GameZebra/BalanceMaster/README.md

# BalanceMaster
A two-wheeled robot that has to balance itself upright

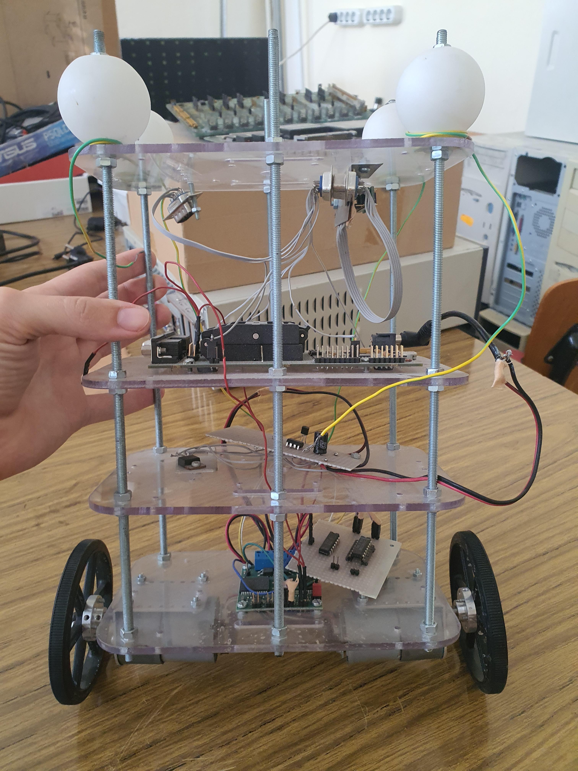
[picture p1: media/robot_upright.jpeg]
Picture of the robot


The board has a polou dual motor driver qik_2s12v10
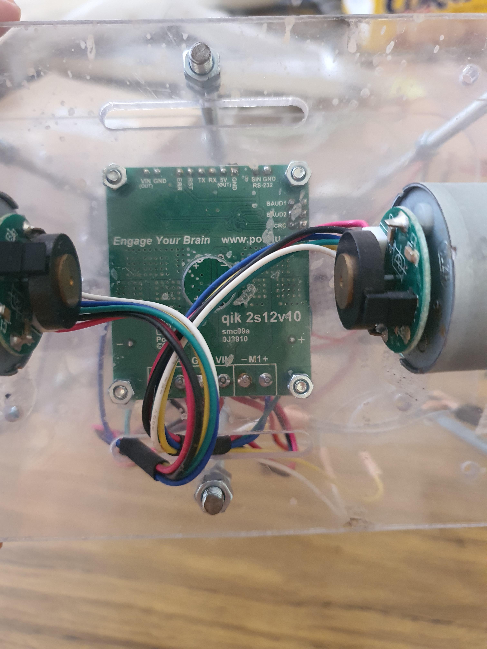
[picture p2: media/motor_driver.jpeg]
Picture of the driver
 

and ADXRS623 gyroscope
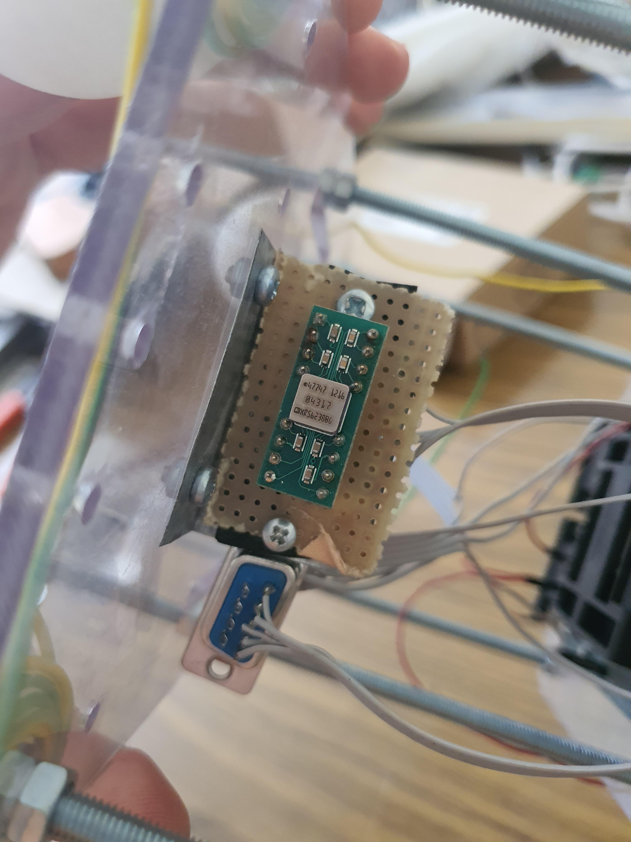
[picture p3: media/gyroscope.jpeg]
