GameZebra/BalanceMaster/docs/log.md

## 📅 May 11, 2025
- 🔍 Research on documentation strategies
- :page_facing_up: log file created
- :page_facing_up: cheetsheet

## 📅 May 12, 2025
- 🔧 Soldered BMS and balancing wires to the battery pack
- 🔧 tested battery capacity (they cant reach 4.20, max 4.15)
- 🎨 made 3d model bracket for the power button

## 📅 May 13, 2025
- 📦 printed the power button bracket
- 🔧 Soldered and fitted the button on the robot
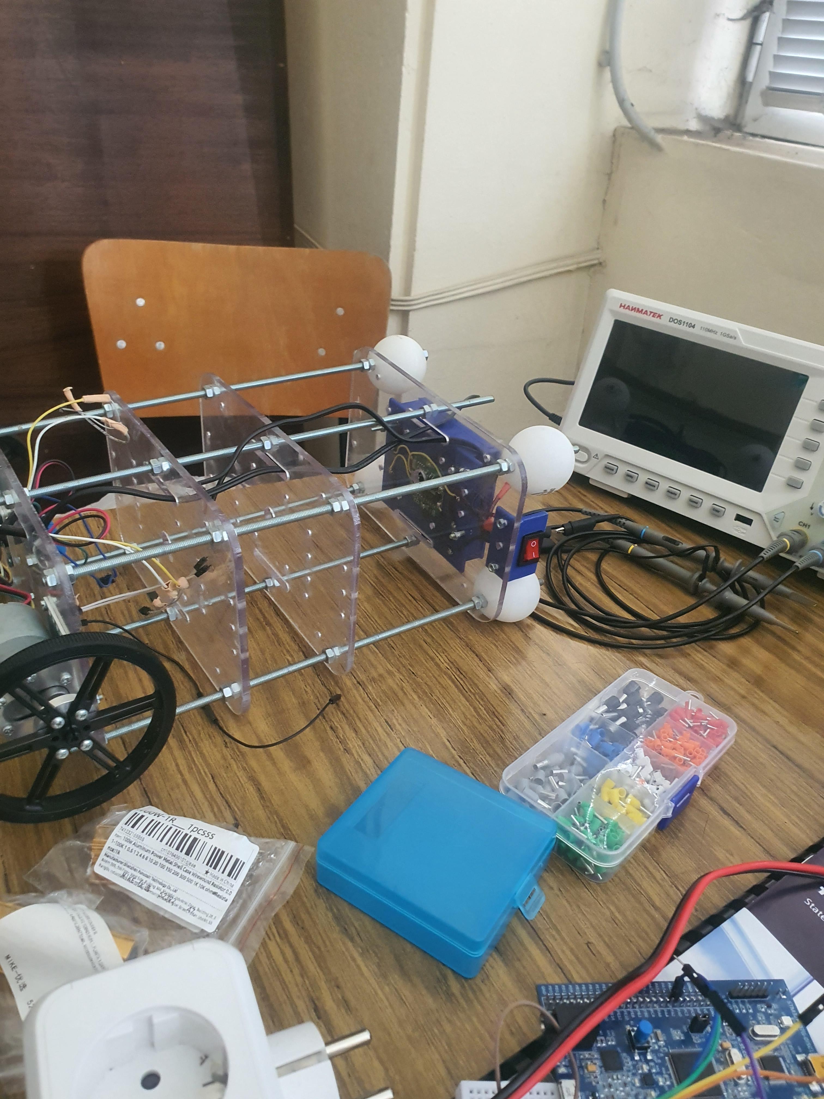
[picture p4: media/fitted_battery_pack_and_power_button.jpeg]
robot fitted with battery pack and power button
  
- 🔧 Made a power rail with buck convertors to stabilize the power
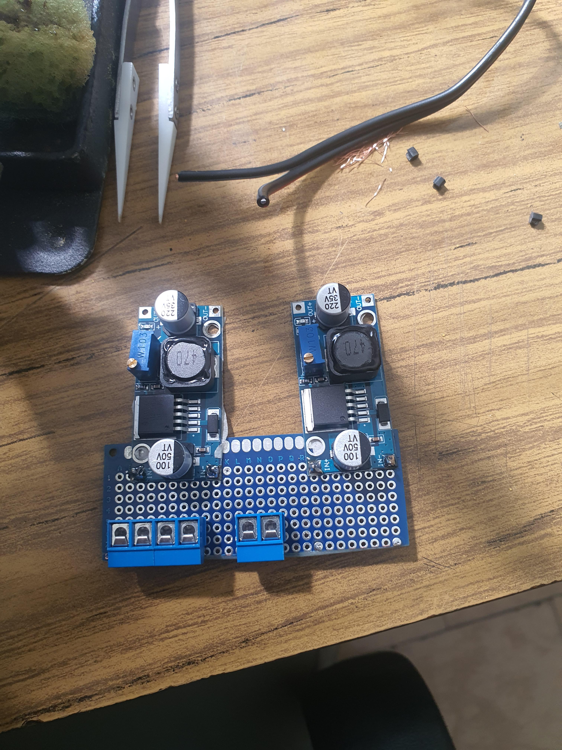
[picture p5: media/power_rail.jpeg]
power rail the upper side of the power rail
  

## 📅 May 14, 2025
- :page_facing_up: fixed prior log data
- 🔍 retested gyro
- 🔧 created gyro board and fited it to the robot
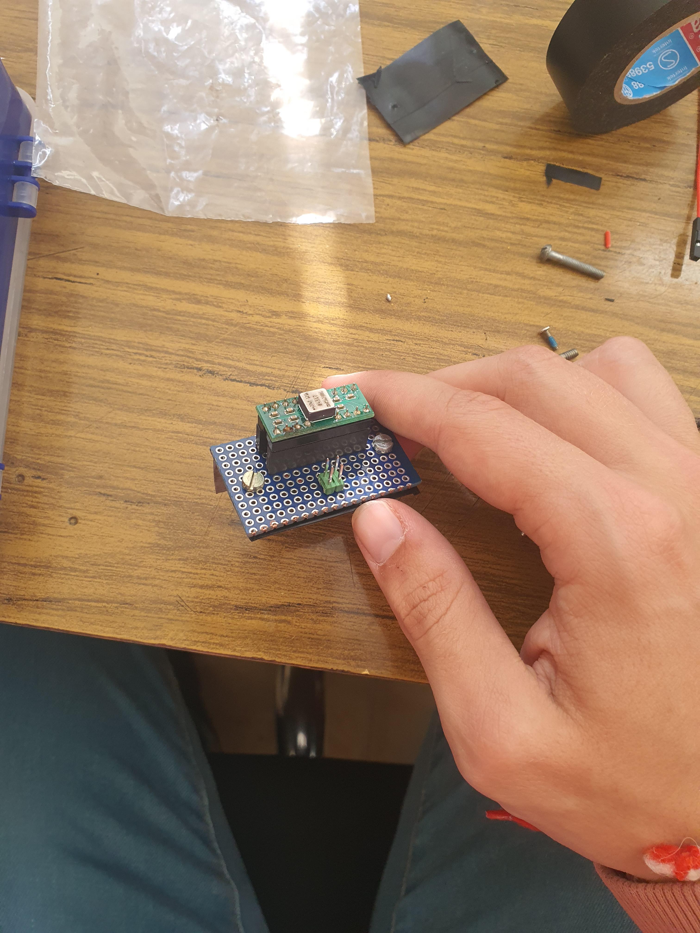
[picture p6: media/gyroscope_board.jpeg]
gyroscope board
 
- :page_facing_up: to the user data file created on the tablet

## 📅 May 15, 2025
- :page_facing_up: created pinout for the project + future improvements
- 🔍 retested gyro on 3V (because the stm32f407 board can read with the ADC up to 3V)
- 🔧 fixed the gyro board to output 3V
- 🔧 created MCU board and fited it to the robot
    - used multitool for the first time
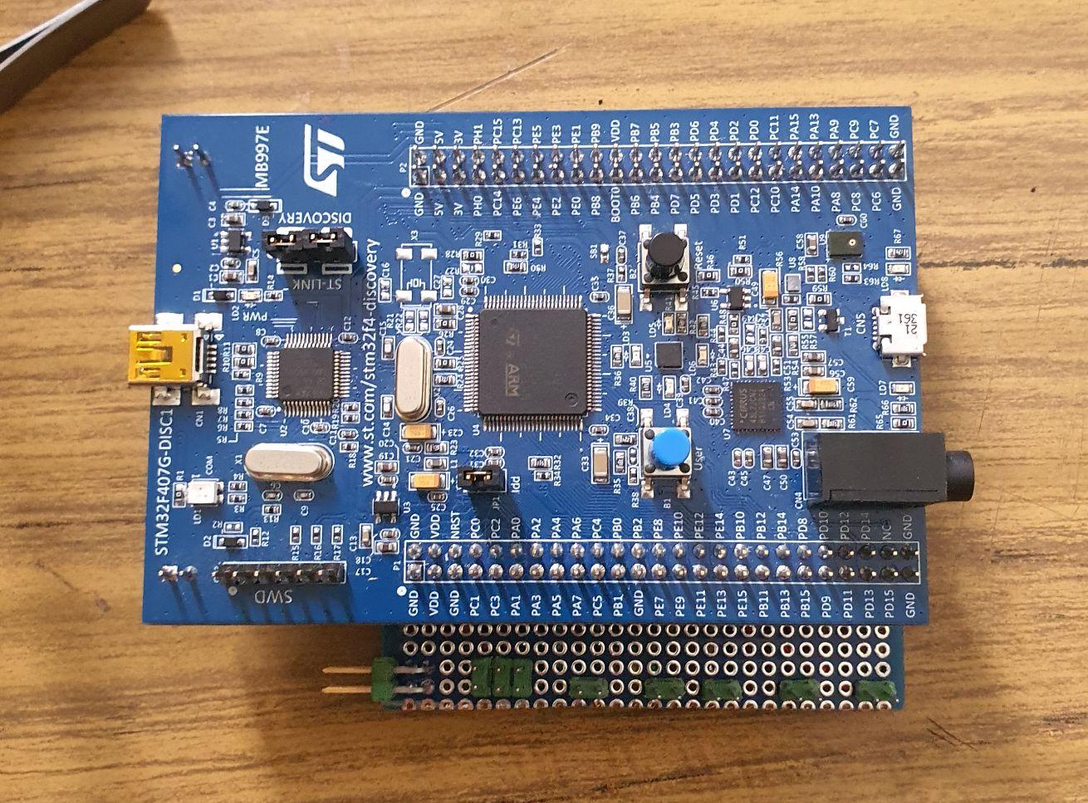
[picture p7: media/MCU_board.jpeg]
MCU board
 
- :page_facing_up: created doc file for the board shield on the tablet
- 🤖 robot hardware done
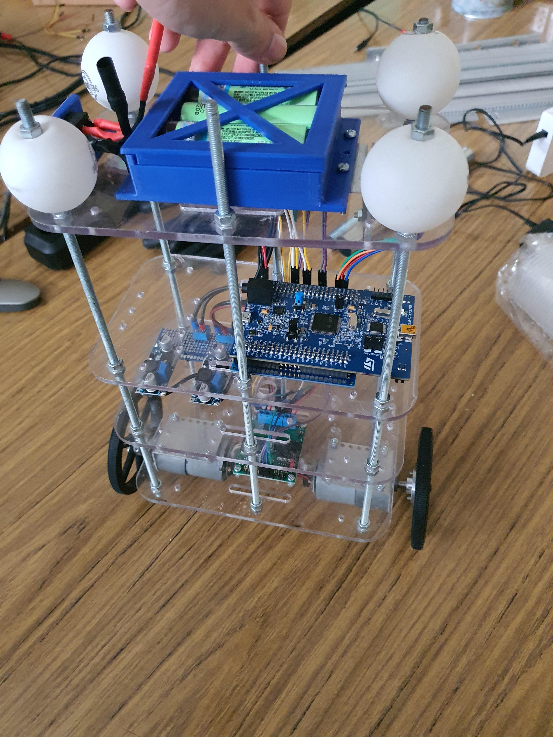
[picture p8: media/robot_upgrade_done.jpeg]
robot upgrade done
 

## 📅 May 20, 2025
- 💻 fixed the Franken bot file, now:
    - reads the gyroscope
    - reads the accelerometer
    - controls the motors
- 💻 added PID algorythim
- 🤖 baddly configured PID, but the robot is trying to stabilize itself

## 📅 May 22, 2025
- 💻 spend a lot of time trying different PID values - didn't work well
    - the robot is trying to stabilize itself, it's much better than the first iteration, 
    BUT it still can't stabilize the robot, nor to compensate for a high diviation from 
    the stable position
    - when the Kd is high the robot seems closer to stabilizeing itself, BUT it's a lot jurkey
    and this heats the motors and the buck converter that stabilizes the volteg for the motor driver
    (to the point taht the buck converter shuts off). Probbably the frequent change in direction 
    requieres high amount of current without almost any meaningfull result
    - tried using a deadzone around the work point, but this worked badly for the responsiveness
    and worked good for the overheating of the motors 
- :page_facing_up: i used already derived differential equations for the mechanics of an inverted pengulum
and derived a State space model from them (by hand)
- 🧠 I am thinking that a much hidher Kd will be required but this makes the motors to overheat
and that's far from ideal. Probbably i should try:
    - filtration of the accelerometer signal 
    - use the gyro - even thou it's signal is far from ideal (correct) it may suffer less from the noise
    generated from the motors (whem jurking around the stable position)
- :page_facing_up: TODO try:
    - high Kd component and larger deadzone
        - i want to get the robot atleast to ascilate around the work point
    - filtration of the signal
    - measure the parameters of the robot and try to create a model in matlab
    - tune a PID in matlab and try it on the robot to see if the model created has anything in common with the actual robot

## 📅 May 23, 2025
- 💻 impemented moving average
    - there is improvement but even thou somethimes there are spikes and, i'm thinkig 
    - I may try adding the average value as current value, this way I'll have even better filtration
- :page_facing_up: I still had large spikes in the Kd component
- 🔍 found a YouTube channel that has decent math and controll videos
    - watched the tutorials for Complex Analisis
- 🔍 found a MatLab example of an inverted pengulum controll which i can try
- 💻 tryed swapping the accelerometer with the gyro
    - didn't go well, i activated a timer to periodically return the gyro in the "correct" angle valye, but how do i know it is "correct"?
    it behaved as a gyro with wrong zero and then when it synced - just jumped on the side, and this was happening every second 
    - if i want to use the gyro I must prepare the data better first
- 🧠 I am thinking that:
    - apart from the filtration i may need to secure better the controller to the body of the robot
    because this way I'm amplifying the vibrations  
    - I may also look at the filtrations that we used in the labs for System Identification
- 🧠 How to implement sequential control? 
    - upright stabilization is acheived by following the zero degrees angle
    - and to acheive movement i can dynamicaly change the target angle so that the car moves linearly in space

## 📅 May 27, 2025
- 🔧 fixed the controler ant the accelerometer to the body of the robot better to limit the vibrations
    - and it is working verry well
- 💻 impemented moving average filtration
    - A great stupidity actually, I'had suspicions about that but
    - this way the angle tends to zero, and is not usefull at all
- 🔍 maged to connect the osciloscope with the PC (it needs it's USB cable to work properly)
- 🔍 The command "Get Motor M0/M1 Speed" returns the speed the driver is trying to speed the motors to - So it's not practical for checking 
if the motrs are not moveing
- 🔍 The command "Get Motor M0/M1 Current" returns average motor current for the past 5ms (+/-20%)
- 🔧 I measured the current throught the motors and the driver in different working conditions (including work mode)
    - TODO: analize the results why does the controller shuts down?
- 💻 improved the encoders demo code:
    - works with both encoders on the propper channels 
    - calculates the wheels actual speed

## 📅 May 28, 2025
- 💻 added code for the second encoders
    - it's interesting how when the encoder variable overflows, the speed variable overflows as well and i don't have massive speed reading
    - min speed added
- 💻 implemented brake before reversing
    - almost workiing

## 📅 May 29, 2025
- 💻 implemented brake before reversing
    - fixed the brake before reversing now stops whell
- 🧠 fix the zero position with bias for the angle
    - implementation (configuration required)

## 📅 May 30, 2025
- 💻 fix the zero position with bias for the angle
    - implementation (configuration required)
- 💥 managed to fry the buck converter that was supplying energy to the motor driver
- 🔧 measured the weight of the robot (to use in matematical model)

## 📅 June 02, 2025
- 🔍 Watched state space tutorials 
- 🔧 got new Buck converter (the same as the last one)

## 📅 June 03, 2025
- 🔍 played with the examples from the tutorials
- 💻 tried to implement angle correction on startup
    - i oscilate it by hand and it finds where the delta is smallest
     unfortunately (i suppose due to the noise of the accelerometer) this way the resulted setpoint is far from the actual zero
- 💻 changed the Kd to be basesd on the previous angle and not on the error to presumably limit the efect on the error based on the adaptive function that changes the angle
- 💻 remove the Ki because of double integration!!!
- 🔍 watched more from the control bootcamp
- 🧠 I talked with my mentor and it is highly advisable to have recordings of the performance of the robot in different strategies
    - with or without Ki
    - for this i have TODO a matlab file that can record the internal states of my robot

## 📅 June 04, 2025
- 🔍 watched more from the control bootcamp
- 💻 created a function that prints the important data to the PC via UART
    - the problem is that when i try to print everything the controll is visibly slower
    - Probbably i will have to use DMA for this
    - or just up the clock speed of the MCU because right now it is at 8 MHz
- 🔍 an interesting fact is the data types with wich the data from the experiment .txt .dat .bin
    - to save the data in .txt will require to convert the data to string first which is impractical for real time aplications
    - so i'll save the data as .bin and convert it in matlab later
    - .dat is some form of hybrid between the two where the data can be different file formats
- 💻 definately the responsiveness improved with increasing the clock speed
- 🔍 a little research about DMA
- 💻 also created matlab file that gets .bin file (from the experiments) and gets and plots the data
    - I should have done this sooner

## 📅 June 05, 2025
- 🔍 how to create header files in c, how are they connected, what to declare where and how to use them
    - fun fact when creating global variables in .h files they won't be created unless used insed the main file (the compiler decedes to optimize them)
- 💻 created separet .h files for different functionalities
    - for controlling the motors
- 🧠 I talked with my mentor: if i have some unbelievable value like 3.2*10^38 degrees (for the robot angle) i can just use the previous value
    - I made it if it is larger than 80 degrees to use the previous value
- 🧠 If the biggest problem for my control is the derivative because the accelerometer becomes very spike from the motr noise
I can just use the gyroscope for it
- 🧠 And the algorythm for the space correction will stabilize small imperfections of my zero position

## 📅 June 12, 2025
- :page_facing_up: made a schematic of the controll for the PID algorythm
- 🧠 My mentor gave me a genious idea kinda feel bad for not figuring it out alone:
    - when the P is too low, the robot is not responsive enough, when the P is too high the robot starts oscilating 
    and becomes unstable
        - the solution? figure out a law by witch to change the P coeficient, insted of beeing constant
    - to do that effectively i have to study the law by witch the robot falls.
        - I'll have to figure out a way to drop the robot reliably from different heights 

## 📅 June 13, 2025
- 🔍 I spend a lot of time figuring out how do electric motors work, why while moveing they draw almost no current. 
What is back EMF, interesting stuff.

## 📅 June 15, 2025
- 🔧 I installed a 15A Boost convertor on the robot hoping that this will increase the speed of the motors and give me the opportunity to save the robot from larger angles.
- 🧠 but it didn't solve the problem with the undervoltage protection of the BMS, 
when the motors try to spin fast the instant current is too high and the batteries voltage drops too low

## 📅 June 16, 2025
- 🧠 because the boost convertor takes more current than the buck convertor to acheive the same energy, i decided to swap it for another buck convertor
- 🔧 swapped the 15A boost convertor with 10A Buck convertor which i hope to be enoudg.
- 🧠 the problem persists, the undervoltage protection kicks in

## 📅 June 17, 2025
- 🔍 I researched thet the internal resistance of the batteries plays a key role in the voltage drop they experience when a big load is connected
- 🔧 swapped the 10A green batteries with 20A pink batteries which should have lower internal resistance 
- 🔧 a little adaptation for them to fit in the case
- 🧠 at first there was no improvement but aafter CHARGING the batteries i resolved the issue

## 📅 June 18, 2025
- 🔍 I researched the Kalman filter, it seams there is an easy 1d version that i can try out

## 📅 June 25, 2025
- 💻 finished the lib files so that i will have a working workspace that is functional 

## 📅 July 6, 2025
- 💻 speed regulator for the motors

## 📅 July 8, 2025
- 🧠 i'm not in real time, the uart communication is too slow for the stm to operate at 100 micro seconds

## 📅 July 11, 2025
- 📊 the speed regulator needs 1.9 ms for the body
    - 🎛️ getting encoders and calculating speed                 - 10 micro secconds
    - 🎛️ calculating moving average (10 values)                 - 24 micro secconds
    - 🎛️ calculating motors control                             - 15 micro secconds
    - 🎛️ communication to motor driver (38400 bps) (4 bytes)    - 1130 micro secconds
    - 🎛️ communication - debug data (115200 bps) (8 bytes)      - 700 micro secconds
- 💻 driver communication speed to 115200 bps
    - 🎛️ communication to motor driver (115200 bps) (4 bytes)   - 386 micro secconds
    - 📊 the cumulative time is now 1.14 ms
- 🔍 energy efficiency is not dependant on clock speed but on the voltage of the processor
and to save energy you need to put the processor in low power mode, so it is actually more efficient to 
have higher clocks, to finish the task faster and to put the cpu in low power mode afterwards
- 📊 the program for the visualization is SearilPlot
    - 🧠 usefull and has the most important feature you can read binary data and interpret it later

## 📅 July 12, 2025
- 💻 matlab file analizing the motors
    - 📊 the dynamics look close with one motor having lower Kp
- 💻 tried using matlab iddata for system identification and pidtune 
    - 🎛️ the results don't look like the actual observations :(

## 📅 July 13, 2025
- 🧠 plan for the remaining time
- 📊 waht is the speed of the motors regulator (without load) 
pid values (Kp = 0.01; Ki =18 Kd =0)
    - 📊 target 110 mm/s 
        - overshot 75%
        - settle time 0.25 s
    - 📊 target 165 mm/s 
        - overshot 76%
        - settle time 0.277 s
    - 📊 target 441 mm/s 
        - overshot 75%
        - settle time 0.401 s
    - 📊 target 771 mm/s 
        - overshot 39%
        - settle time 0.51 s
- 💻 fixed the mcu Td and the matlab file and now the values it gives are good 
- 📊 waht is the speed of the motors regulator (without load) 
pid values (Kp = 0.389; Ki =24.5 Kd =0.000423)
    - 📊 target 200 mm/s 
        - overshot %
        - settle time 0.144 s
    - 📊 target 800 mm/s 
        - overshot %
        - settle time 0.49 s
    - 📊 target 1000 mm/s 
        - overshot %
        - settle time 0.202 s
- 🧠 even thou the time response is slow (200 ms), it is mostly because of overshoot and oscilations
and i think that these oscilations will be a lot smaller with more graduate change of the setpoint

## 📅 July 14, 2025
- 💻 fixed the libraries
    - 💻 moved everything tested in the past couple of days
- 💻 made the speed regulator work in the combined file
- 💻 made the balance regulator
    - 💻 it is currenty badly tuned
- 🧠 There is some misterious 8.193 ms constant delay for everything that is not with the higest priority interup?
- 📊 the speed regulator needs 425 us (in the big file with highest interupt priority)
- 📊 the andgle regulator needs 403 us (when with highest priority)
- 🧠 so far when both timers are with priority 0 both measure time in the us 
- 📊 gyro function 25 us (when priority 1)

## 📅 July 15, 2025
- 💻 remove the if gyro filtration
- 💻 make a starting gyro function, that zeros the still position velocity
- 📊 record raw data for the accelerometer and the gyroscope
- 💻 implement iir filter (3rd order)
    - 🧠 the controll became unstable

## 📅 July 16, 2025
- 🧠 filtration in real time for controling real time systems is not as trivial as filtering data offline and judje the performance of the filter visually by the error from the real value. Filters introduce phase shift whitch can make the plant unstable
whitch happend yesterday 🙂. To prevent that you need to use 3-5 times faster filter than the controll loop bandwith. And then it works
- 💻 i fixed the filters phase shifts 
- 🧠 and after all this the best filter i made was arguably worst than an 10th order moving average ...
- 💻 implemented anti windup in the pid algorytm

## 📅 July 19-21, 2025
- 💻 matlab model of working kalman filter 
- 💻 trynig to add CMSIS DSP library for matrix multiplication on the stm

## 📅 July 22, 2025
- 💻 working kalman filter on the stm32 
- 💻 trying different constants for the PIDs

## 📅 July 25, 2025
- 💻 the robot balances for 19 secs (by accident)
- 🧠 couldn't make it second time 😭

## 📅 July 26, 2025
- 🧠 a lot of tries to make the robot balance
- 😭 (depression)

## 📅 July 27, 2025
- 💻 made a matlab vizualization of the control variables
- 🧠 the motors slow down when they aproach the target angle... and by the time they figure out they have to start speeding again it is too late and the robot is not recoverable

## 📅 July 28, 2025
- 💻 made 4th order Kalman filter trying to evaluate the angle offset where the robot is stationary
    - 🧠 didn't work as good as I expected. There isn't a good way to model this ofset
- 🧠 the regulator at the bottom only makes the controll harder because it isn't fast enoug and the dynamics of the motor show up. I can either remove it, or make it fast enough.
    - 🧠 if i go on the rout of removing it i may try adding one or two fast regulators that equlize the dynamics of both motors, for example some K < 1 in front of the faster one 
    - 🧠 i would probably need around 80mF capacitors at the output to make the fast regulator work

- 🧠 do i need speed regulator at the bottom?
    - 🧠 yes atleast to equlize the time response of the motors

## 📅 July 28, 2025
- 🛒 I ordered capaitors to possibly improve the power characterisics of the robot
- 🧠 Talked about the robot controll with my mentor and it seems i have structural problem not only parameter 😢
- 🧠 I have problem with the Angular Velocity. The gyro has some bias (I don't know from where) and it may (absolutely) interfieres with my contol. The kalman filter cant fix it. It becomes internaly unstable.
    - 🧠 I can try filtering the angular velocity and adding the bias as a state. to improve the angular velocity estimation.
- :page_facing_up: I got Plamen's thesis to use as a template.

## 📅 July 28, 2025
- :page_facing_up: for the documentation: 
    - 12V DC brushsed motors with 29:1 gearboxes
    - magnetic quadrature encoders for measuring wheels angles
    - single precision calculations
    - in the example they are using Ts= 0.005 s
- :page_facing_up: template for the thesis
- :page_facing_up: plan conspect for the writing

### to ask
- what do they get when integrating 3 times angle?
- don't they get the speed by derivative of an angle?
- why double intgration is not desirable

### For tomorow
- digital filtration for the gyroscope
    - make DFT of the colected signal
    - check if the filter has big phase shift 
- filtration for the accelerometer
    - make DFT of the colected signal
    - check if the filter has big phase shift 
- make cascade pid control (position control)
- make 1d calman

## TODO
- try increasing the Kd to limit the oscilations of the speed regulator
- think of a formula for dynamic PID values
    - find good values for low error and slightly larger
    - make linear interpolation between these points
