GameZebra/BalanceMaster/docs/25-STM32F407VGT6-5.jpg

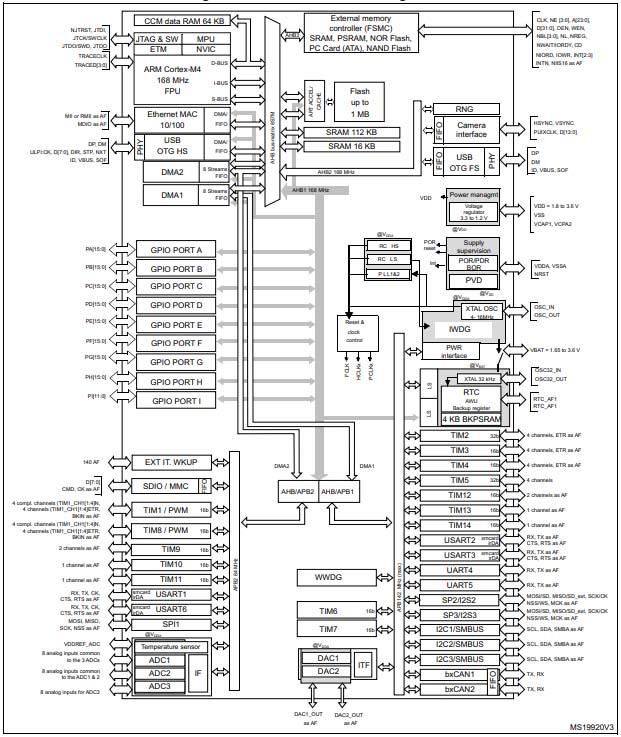
docs/25-STM32F407VGT6-5.jpg
