GameZebra/BalanceMaster/docs/AHB1_rcc_register.png

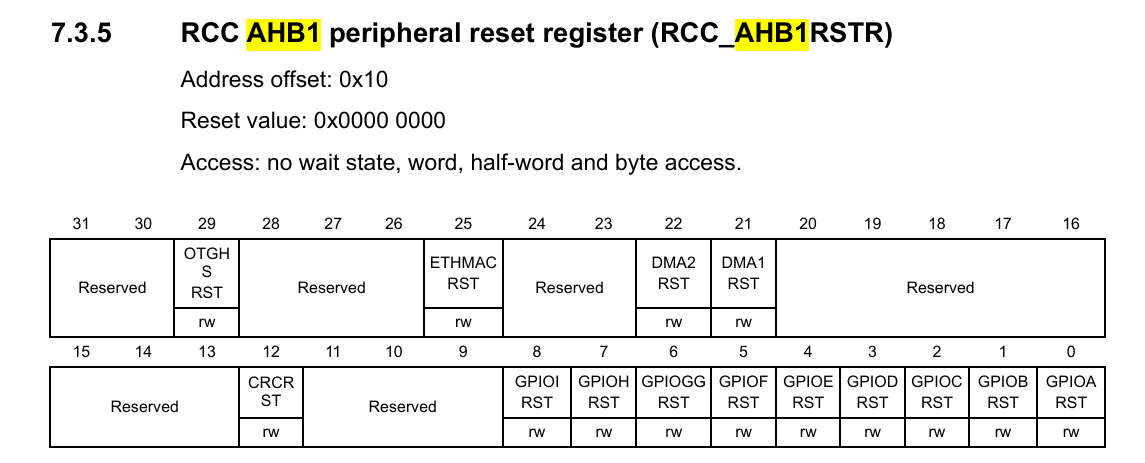
docs/AHB1_rcc_register.png
