GameZebra/BalanceMaster/docs/gyro_board_eval-adxrs623z_2.jpg

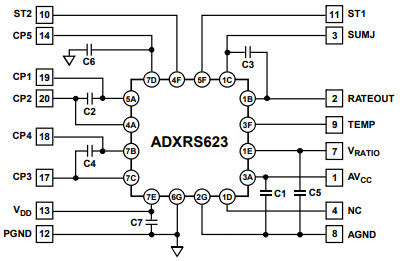
docs/gyro_board_eval-adxrs623z_2.jpg
