GameZebra/BalanceMaster/media/encoder_ic.jpeg

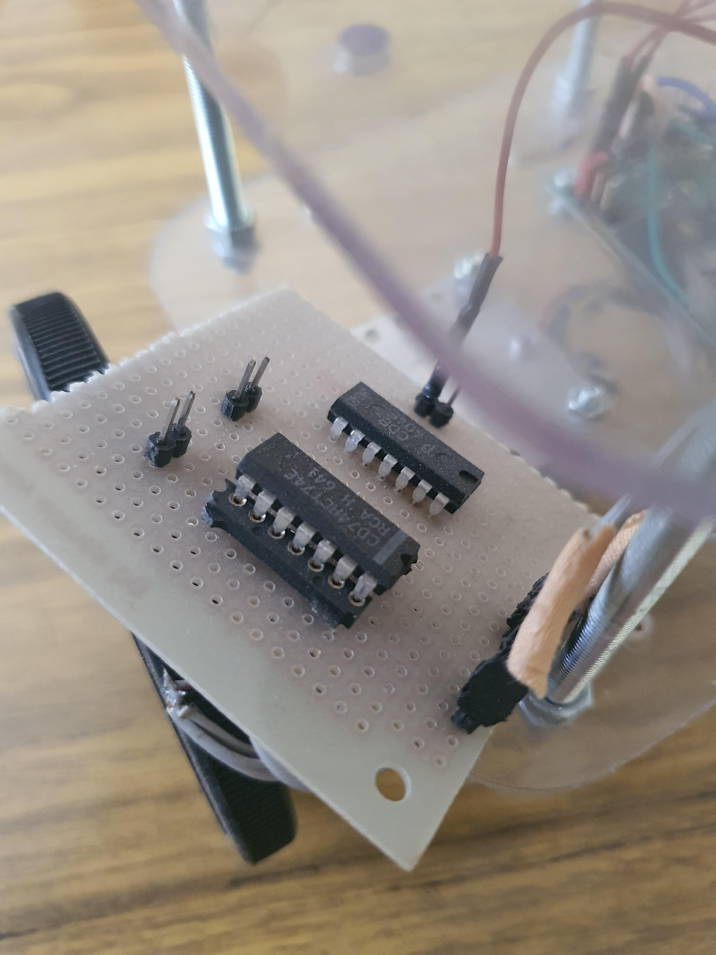
media/encoder_ic.jpeg
