GameZebra/BalanceMaster/system_identification/encoder_filtration/encoder_speed_fir.png

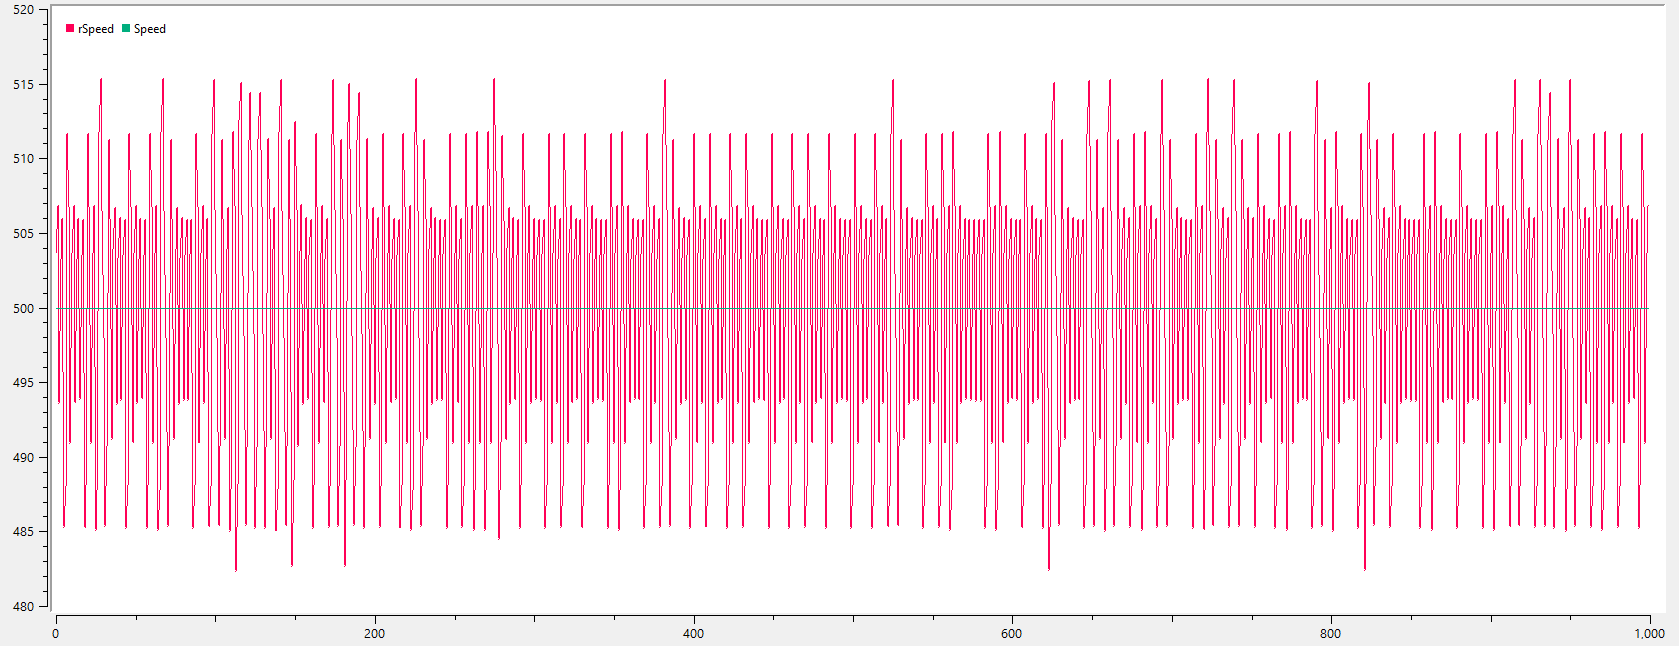
system_identification/encoder_filtration/encoder_speed_fir.png
