GameZebra/BalanceMaster/system_identification/encoder_filtration/encoder_speed_fir_mva.png

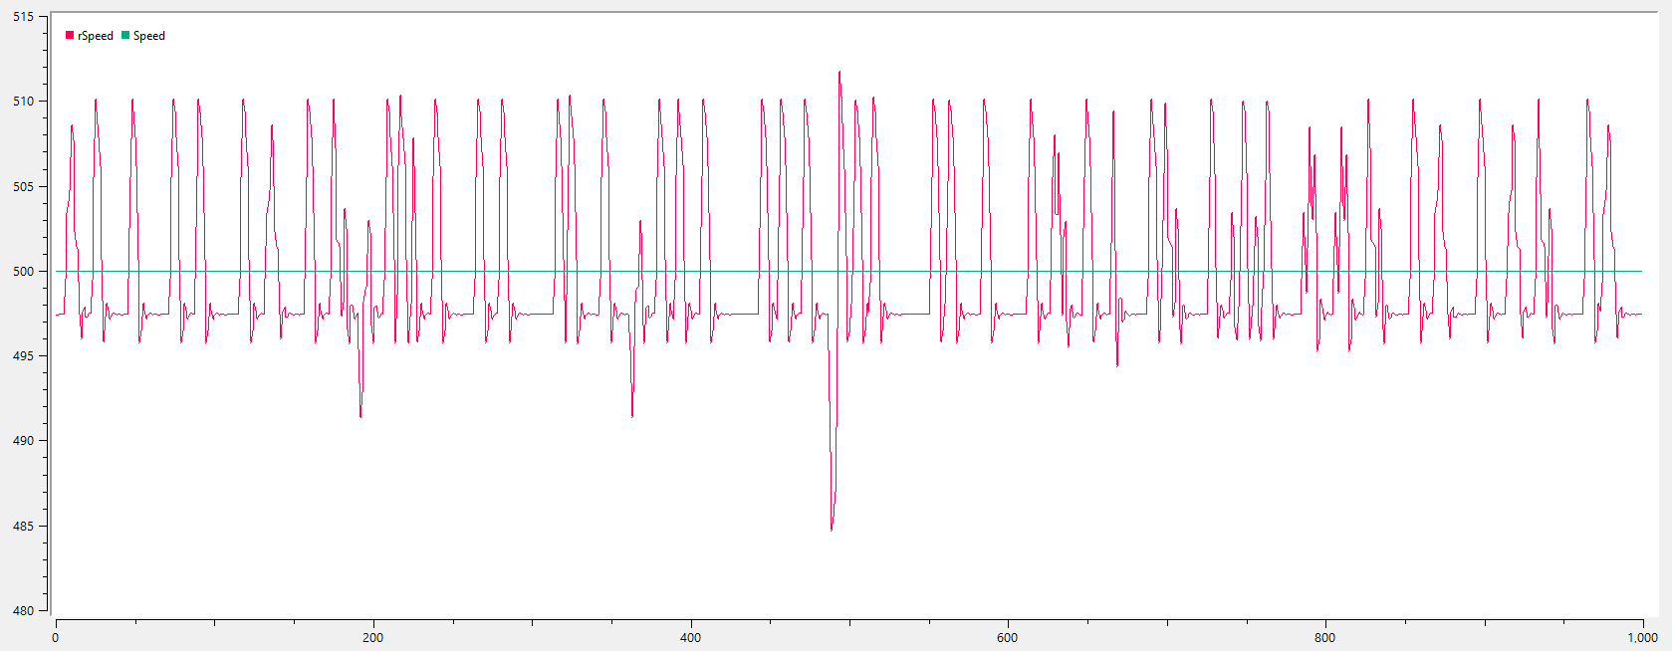
system_identification/encoder_filtration/encoder_speed_fir_mva.png
