GameZebra/BalanceMaster/system_identification/encoder_filtration/encoder_speed_fir_mva_plus_control.png

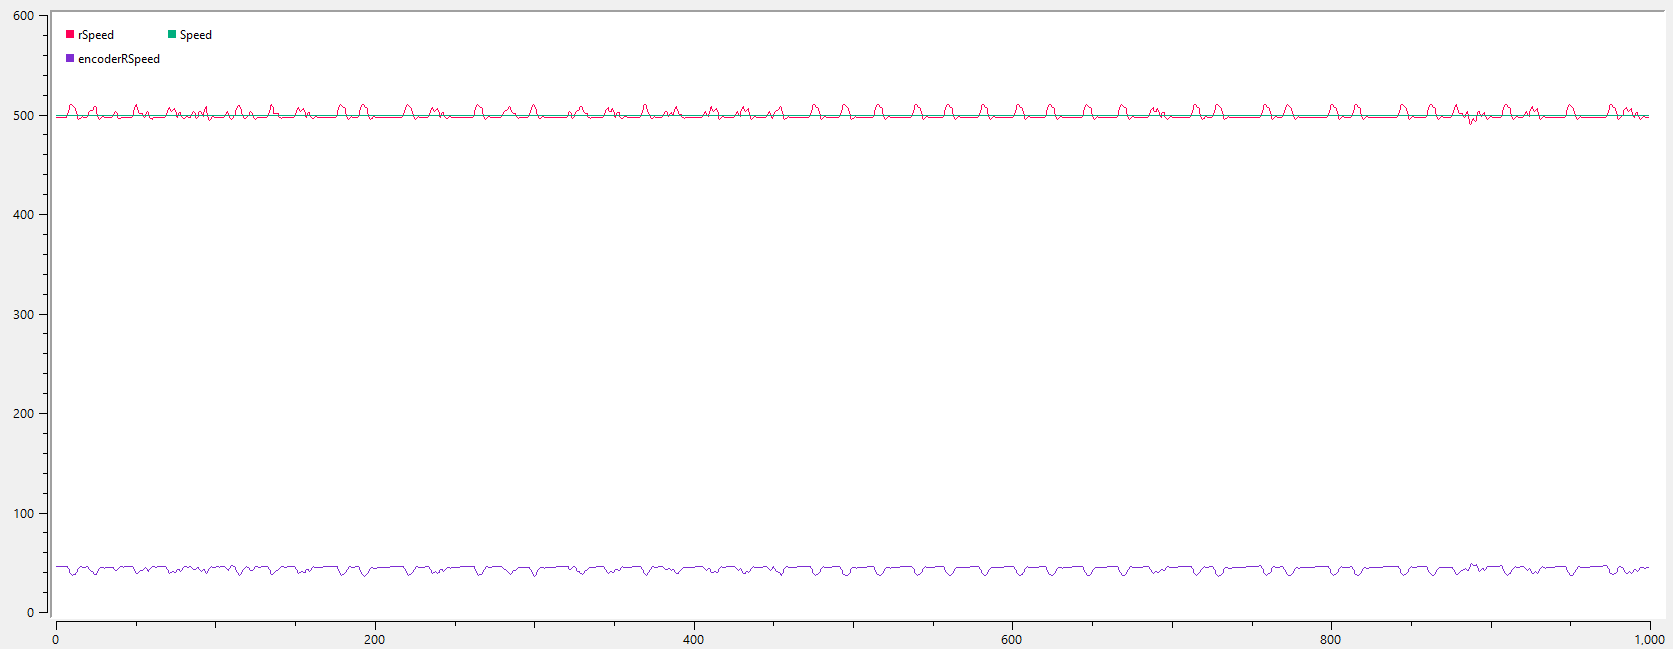
system_identification/encoder_filtration/encoder_speed_fir_mva_plus_control.png
