GameZebra/BalanceMaster/system_identification/encoder_filtration/encoder_speed_moving_average.png

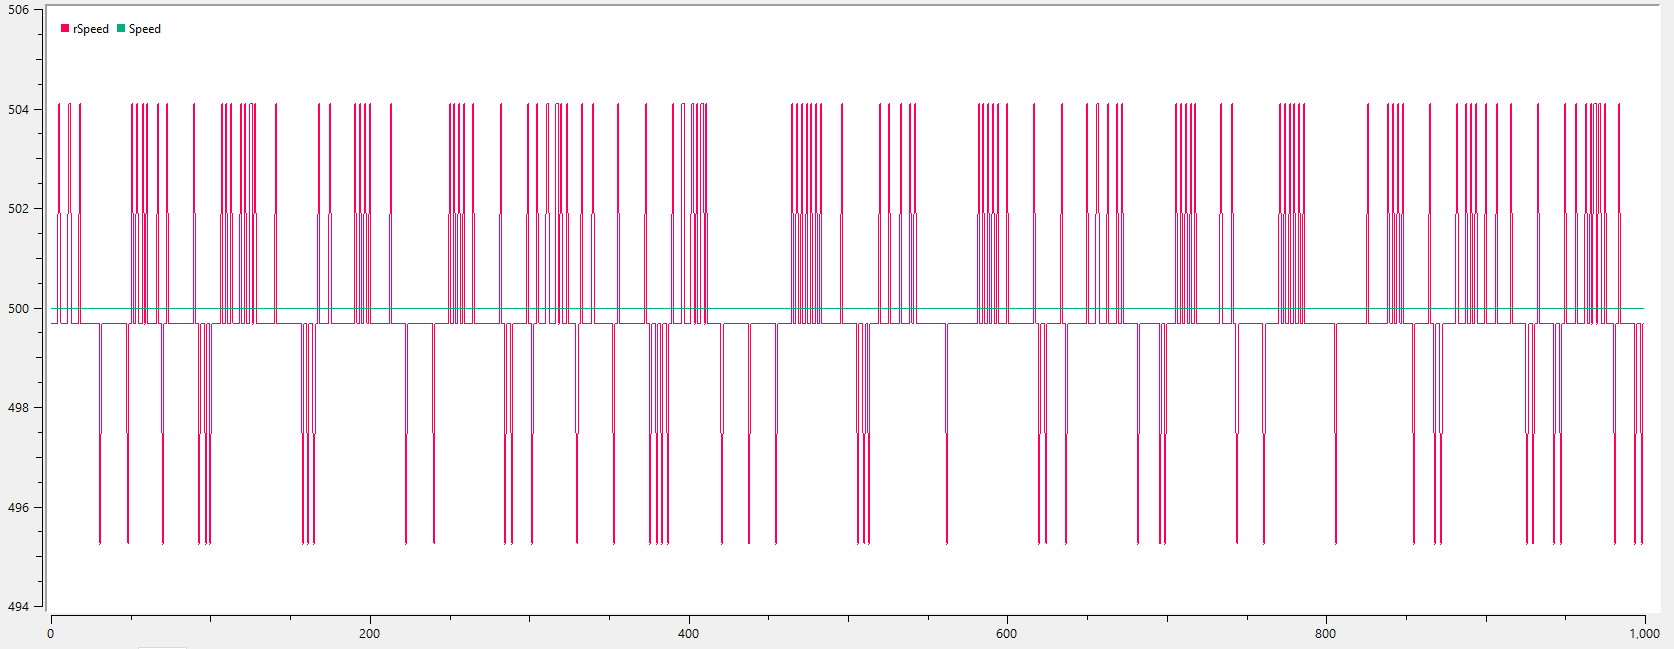
system_identification/encoder_filtration/encoder_speed_moving_average.png
