GameZebra/BalanceMaster/initial_tests/GyroRead/README.md

 

The gyro used is ADXRS623 with evaluation board. It needs to be powered with 5v at 3 places in order to function Vac, Vdd and Vratio. and graound at 2 places.

After the board is powered we have to read the output from pin 2 RATEOUT. It gives output voltage proportional to the Angular Velocity of the chip.

Recuires software integrator and reset button to capture the angle of the robot.
