GameZebra/BalanceMaster/initial_tests/FrankenBotCombination/PCCommunicationTest_01.txt

0B0C260C002C0D0A0E260C002C0D0A0F260C002C0D0A11260C002C0D0A13260C002C0D0A14260C002C0D0A16260C002C0D0A17260C002C0D0A18260C002C0D0A1A260C002C0D0A1B260C002C0D0A1C260C002C0D0A1E260C002C0D0A1F260C002C0D0A21260C002C0D0A23260C002C0D0A24260C002C0D0A26260C002C0D0A27260C002C0D0A28260C002C0D0A2A260C002C0D0A2B260C002C0D0A2D260C002C0D0A2F260C002C0D0A30260C002C0D0A32260C002C0D0A33260C002C0D0A34260C002C0D0A36260C002C0D0A37260C002C0D0A39260C002C0D0A3B260C002C0D0A3C260C002C0D0A3E260C002C0D0A40260C002C0D0A41260C002C0D0A43260C002C0D0A44260C002C0D0A45260C002C0D0A47260C002C0D0A48260C002C0D0A4A260C002C0D0A4C260C002C0D0A4D260C002C0D0A4F260C002C0D0A50260C002C0D0A51260C002C0D0A53260C002C0D0A54260C002C0D0A56260C002C0D0A58260C002C0D0A59260C002C0D0A5B260C002C0D0A5D260C002C0D0A5E260C002C0D0A60260C002C0D0A61260C002C0D0A63260C002C0D0A65260C002C0D0A66260C002C0D0A68260C002C0D0A6A260C002C0D0A6B260C002C0D0A6D260C002C0D0A6E260C002C0D0A6F260C002C0D0A71260C002C0D0A72260C002C0D0A74260C002C0D0A76260C002C0D0A77260C002C0D0A79260C002C0D0A7A260C002C0D0A7B260C002C0D0A7D260C002C0D0A7E260C002C0D0A80260C002C0D0A82260C002C0D0A83260C002C0D0A85260C002C0D0A86260C002C0D0A87260C002C0D0A89260C002C0D0A8A260C002C0D0A8C260C002C0D0A8E260C002C0D0A8F260C002C0D0A91260C002C0D0A93260C002C0D0A94260C002C0D0A96260C002C0D0A97260C002C0D0A98260C002C0D0A9A260C002C0D0A9B260C002C0D0A9D260C002C0D0A9F260C002C0D0AA0260C002C0D0AA2260C002C0D0AA4260C002C0D0AA6260C002C0D0AA8260C002C0D0AAA260C002C0D0AAC260C002C0D0AAE260C002C0D0AB0260C002C0D0AB2260C002C0D0A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
