GameZebra/BalanceMaster/system_identification/accelerometer_tests/acc_data.csv

timestamp | angle
1755190546345 | 87.431183
1755190546353 | 87.445709
1755190546362 | 87.450912
1755190546373 | 87.443192
1755190546383 | 87.436928
1755190546394 | 87.430298
1755190546404 | 87.430527
1755190546413 | 87.441780
1755190546423 | 87.439888
1755190546435 | 87.441704
1755190546445 | 87.454750
1755190546454 | 87.476021
1755190546464 | 87.479004
1755190546476 | 87.454887
1755190546486 | 87.438385
1755190546495 | 87.424637
1755190546505 | 87.422012
1755190546515 | 87.419785
1755190546527 | 87.426704
1755190546536 | 87.428299
1755190546546 | 87.435631
1755190546557 | 87.455650
1755190546567 | 87.480591
1755190546578 | 87.472366
1755190546587 | 87.480011
1755190546597 | 87.480560
1755190546608 | 87.480751
1755190546618 | 87.486359
1755190546628 | 87.486069
1755190546639 | 87.480057
1755190546650 | 87.472824
1755190546660 | 87.472290
1755190546670 | 87.491684
1755190546680 | 87.508881
1755190546691 | 87.512947
1755190546701 | 87.496223
1755190546710 | 87.500290
1755190546721 | 87.483978
1755190546730 | 87.480431
1755190546741 | 87.473465
1755190546752 | 87.469147
1755190546762 | 87.469673
1755190546771 | 87.472214
1755190546783 | 87.498726
1755190546793 | 87.505623
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
