GameZebra/BalanceMaster/system_identification/accelerometer_tests/acc_velocity_normal_work_motors_on.csv

accAngle | angularVelocity
0.528483 | 2.100631
0.280989 | 1.899621
0.046407 | 1.698595
-0.056260 | 1.397081
-0.270853 | 0.995046
-0.253957 | 0.995046
-0.271009 | 0.593011
-0.182449 | 0.291497
-0.056332 | 0.090488
-0.089205 | 0.190993
-0.247818 | 0.291497
-0.324356 | -0.010033
-0.287816 | -0.110538
-0.195514 | 0.291497
-0.132598 | -0.914592
0.301833 | -0.814087
0.720206 | -1.015096
0.959771 | -0.613078
1.084468 | -0.311547
1.213305 | 0.693532
1.003054 | 1.196055
0.732449 | 1.899621
0.465460 | 1.397081
0.458462 | 1.698595
0.353042 | 2.100631
0.557694 | 2.100631
0.547605 | 2.402144
0.609295 | 2.703675
0.565466 | 3.507728
0.330612 | 3.507728
-0.069437 | 3.809259
-0.361682 | 3.206215
-0.469980 | 3.206215
-0.666315 | 3.105710
-0.944965 | 2.603170
-1.168059 | 1.899621
-1.085747 | 1.497586
-1.159139 | 1.899621
-1.223083 | 0.894542
-0.865649 | 0.894542
-0.778382 | 0.693532
-0.635601 | 0.090488
-0.549345 | -0.211043
-0.649711 | -0.311547
-0.825578 | -0.914592
-0.874576 | -0.914592
-0.887876 | -0.613078
-0.737361 | -0.814087
-0.764294 | -1.115601
-0.525574 | -1.517636
-0.218382 | -2.020176
0.033096 | -2.221185
0.287269 | -1.819167
0.310400 | -1.718645
0.251165 | -1.216122
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
