GameZebra/BalanceMaster/system_identification/accelerometer_tests/acc_velocity_normal_work_no_motors.csv

accAngle | angularVelocity
-0.433199 | -0.592977
-0.555354 | -0.090437
-0.413478 | -0.291446
-0.475884 | -0.693482
-0.574457 | -0.492472
-0.565368 | 0.010067
-0.398134 | 0.211077
-0.314155 | 0.311598
-0.327155 | 0.311598
-0.402996 | 0.211077
-0.351422 | 0.010067
-0.503395 | 0.211077
-0.773372 | 0.110572
-0.849278 | 0.110572
-0.871163 | 0.412103
-0.853567 | 0.010067
-0.671818 | 0.512607
-0.624624 | 0.311598
-0.410146 | -0.291446
-0.352033 | -0.190942
-0.353571 | 0.010067
-0.476406 | -0.190942
-0.658733 | 0.010067
-0.672051 | 0.311598
-0.582133 | 0.311598
-0.581093 | 0.412103
-0.480380 | 0.311598
-0.264996 | 0.211077
0.019842 | 0.512607
-0.095834 | 0.713616
-0.049624 | 0.814121
-0.228269 | 1.015147
-0.535768 | 1.316661
-0.740838 | 1.919705
-0.945476 | 1.517687
-0.963782 | 1.417165
-0.960340 | 1.316661
-0.708095 | 1.115652
-0.477012 | 0.914643
-0.287966 | 1.919705
-0.483833 | 1.015147
-0.721621 | 1.316661
-0.798069 | 1.819201
-1.056070 | 2.120731
-1.120387 | 2.120731
-1.157032 | 1.517687
-1.094459 | 1.115652
-0.849180 | 1.919705
-0.715622 | 1.618191
-0.669630 | 0.814121
-0.682573 | 1.417165
-0.702736 | 2.221236
-0.871213 | 1.618191
-1.047392 | 1.517687
-1.018733 | 1.517687
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
