GameZebra/BalanceMaster/system_identification/accelerometer_tests/acc_velocity_stationary_1.csv

accAngle | angularVelocity
87.782784 | 1.825295
87.687607 | 1.724791
87.676987 | 1.624286
87.639488 | 1.322756
87.669777 | 1.121746
87.632576 | 2.026322
87.585274 | 2.126826
87.573944 | 2.026322
87.578529 | 2.026322
87.623009 | 1.925800
87.537888 | 1.925800
87.486580 | 1.925800
87.738197 | 1.423277
87.665230 | -0.190942
87.599152 | 0.311598
87.560860 | 0.211077
87.557137 | 0.412103
87.619232 | 0.613112
87.722679 | 0.010067
87.668503 | -0.190942
87.543777 | 0.010067
87.590317 | -0.291446
87.573540 | -0.190942
87.826454 | -0.190942
87.575455 | 0.110572
87.523178 | 0.211077
87.692001 | 0.412103
87.722679 | 1.015147
87.616943 | 0.010067
87.492035 | -0.291446
87.591049 | -0.391968
87.638664 | -0.391968
87.539970 | 0.010067
87.745712 | 0.110572
87.640846 | 0.412103
87.521561 | 0.613112
87.683655 | 0.211077
87.708076 | 0.110572
87.610863 | 0.010067
87.679703 | 0.010067
87.633995 | 0.512607
87.477264 | 0.512607
87.499161 | 0.512607
87.619385 | 0.110572
87.647949 | 0.110572
87.609482 | 0.512607
87.619232 | 0.412103
87.621521 | 0.211077
87.674919 | 0.211077
87.488380 | 0.010067
87.616493 | -0.391968
87.656059 | 0.512607
87.852280 | 0.512607
87.399429 | 0.110572
87.684395 | 0.110572
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
