GameZebra/BalanceMaster/BMasterControl/SteadyBalancePID/Core/Src/main.c

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
/* Includes ------------------------------------------------------------------*/
#include "main.h"

/* USER CODE BEGIN Includes */
#include "qik_2s12v10_lib.h"
#include "accelerometer.h"
#include "gyroscope.h"
#include "encoders.h"
#include "control.h"
#include "uart_debug.h"
#include "filters.h"
#include "KalmanFilter.h"

/* USER CODE END Includes */

ADC_HandleTypeDef hadc1;

SPI_HandleTypeDef hspi1;

TIM_HandleTypeDef htim2;
TIM_HandleTypeDef htim3;
TIM_HandleTypeDef htim5;
TIM_HandleTypeDef htim8;
TIM_HandleTypeDef htim10;
TIM_HandleTypeDef htim11;
TIM_HandleTypeDef htim13;
TIM_HandleTypeDef htim14;

UART_HandleTypeDef huart4;
UART_HandleTypeDef huart5;
UART_HandleTypeDef huart2;

/* USER CODE BEGIN PV */

volatile uint16_t cnt1, cnt2, cnt3, cnt4;

/* USER CODE END PV */

void SystemClock_Config(void);
static void MX_GPIO_Init(void);
static void MX_SPI1_Init(void);
static void MX_ADC1_Init(void);
static void MX_TIM2_Init(void);
static void MX_TIM3_Init(void);
static void MX_USART2_UART_Init(void);
static void MX_TIM10_Init(void);
static void MX_UART4_Init(void);
static void MX_UART5_Init(void);
static void MX_TIM11_Init(void);
static void MX_TIM5_Init(void);
static void MX_TIM8_Init(void);
static void MX_TIM14_Init(void);
static void MX_TIM13_Init(void);
/**
  * @brief  The application entry point.
  * @retval int
  */
int main(void)
{

  /* MCU Configuration--------------------------------------------------------*/

  /* Reset of all peripherals, Initializes the Flash interface and the Systick. */
  HAL_Init();

  /* Configure the system clock */
  SystemClock_Config();

  /* Initialize all configured peripherals */
  MX_GPIO_Init();
  MX_SPI1_Init();
  MX_ADC1_Init();
  MX_TIM2_Init();
  MX_TIM3_Init();
  MX_USART2_UART_Init();
  MX_TIM10_Init();
  MX_UART4_Init();
  MX_UART5_Init();
  MX_TIM11_Init();
  MX_TIM5_Init();
  MX_TIM8_Init();
  MX_TIM14_Init();
  MX_TIM13_Init();
  /* USER CODE BEGIN 2 */

  KalmanInit();

  HAL_TIM_Base_Start(&htim8);
  HAL_ADC_Start_IT(&hadc1);

  calculateGyroAVelocityBase(50);

  AccelInit(&hspi1);

//  __HAL_TIM_SET_COMPARE(&htim10,TIM_CHANNEL_1, 10); // questionable?

  HAL_TIM_Encoder_Start(&htim2, TIM_CHANNEL_1);
  HAL_TIM_Encoder_Start(&htim2, TIM_CHANNEL_2);

  __HAL_TIM_SET_COUNTER(&htim3, START_POSITION);				// middle position
  HAL_TIM_Encoder_Start(&htim3, TIM_CHANNEL_1);
  HAL_TIM_Encoder_Start(&htim3, TIM_CHANNEL_2);

  HAL_TIM_Base_Start_IT(&htim10);	// 10ms
  HAL_TIM_Base_Start_IT(&htim14);	// 2ms
  HAL_TIM_Base_Start_IT(&htim13);	// 100ms


  //IIR3_Init(&lFilter, b, a);
  //IIR3_Init(&rFilter, b, a);

  /* USER CODE END 2 */

  /* Infinite loop */
  /* USER CODE BEGIN WHILE */
  while (1)
  {
	  // Test

	  //TestDriver(&huart2);
	  //readAccelerometer(&hspi1);
	  //volatile gyroAngle;

	   //readAccelerometer(&hspi1);
	   //getEncoders(&htim2, &htim3);
	   //calculateSpeed();
	   //pcTransmitBin(&huart5);
	   //moveMotors(&huart2, &htim5, speed);



    /* USER CODE END WHILE */

    /* USER CODE BEGIN 3 */
  }
  /* USER CODE END 3 */
}

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
/* USER CODE BEGIN 4 */

void HAL_TIM_PeriodElapsedCallback(TIM_HandleTypeDef *htim)
{
	if (htim->Instance == TIM14){

		  __HAL_TIM_SET_COUNTER(&htim11, 0);
		  HAL_TIM_Base_Start(&htim11);

		  getEncoders(&htim2, &htim3);
		  filterEncodersMovingAverage();
//		  lSpeed = IIR3_Process(&lFilter, encoderLSpeed);
//		  lSpeed = movingAverage(MAValuesL, lSpeed, EncoderMovAvgOrder-1);
//		  rSpeed = IIR3_Process(&rFilter, encoderRSpeed);
//		  rSpeed = movingAverage(MAValuesR, rSpeed, EncoderMovAvgOrder-1);


		  rightCtrl = motorControl(speed, rSpeed, Kp0, Ki0, Kd0, &integralR, &previousRSpeed, encoderTd, &dirR);
		  leftCtrl = motorControl(speed, -lSpeed, Kp0, Ki0, Kd0, &integralL, &previousLSpeed, encoderTd, &dirL);
		  float fRCtrl = (float)rightCtrl;

		  RightMotorSpeed(&huart2, &rightCtrl, dirR);
		  LeftMotorSpeed(&huart2, &leftCtrl, dirL);

//		  HAL_UART_Transmit(&huart5, &rSpeed, 4, 1);
//		  HAL_UART_Transmit(&huart5, &fRCtrl, 4, 1);
//		  HAL_UART_Transmit(&huart5, &speed, 4, 1);


		  HAL_TIM_Base_Stop(&htim11);
		  cnt1 = __HAL_TIM_GET_COUNTER(&htim11);

	}
	if (htim->Instance == TIM10){
		  __HAL_TIM_SET_COUNTER(&htim11, 0);
	  	  HAL_TIM_Base_Start(&htim11);

	  	  readAccelerometer(&hspi1);
		  KalmanPredict();
		  KalmanUpdate();
		  speed = calculateTargetSpeed(targetAngle, X_data[0], X_data[1], Kp1, Ki1, Kd1, &integralAngle, &previousFilteredAngle, angleTd);


		  float targetPositionf = (float)targetPosition;
		  HAL_UART_Transmit(&huart5, &targetPositionf, 4, 1);
		  float currentPositionf = (float)currentPosition;
		  HAL_UART_Transmit(&huart5, &currentPositionf, 4, 1);
		  HAL_UART_Transmit(&huart5, &targetAngle, 4, 1);
		  HAL_UART_Transmit(&huart5, &X_data[0], 4, 1);
		  HAL_UART_Transmit(&huart5, &X_data[1], 4, 1);

		  HAL_UART_Transmit(&huart5, &accAngle, 4, 1);
		  HAL_UART_Transmit(&huart5, &angularVelocity, 4, 1);

		  HAL_UART_Transmit(&huart5, &speed, 4, 1);
		  HAL_UART_Transmit(&huart5, &rSpeed, 4, 1);
		  float rightCtrlf = (float)rightCtrl;
		  if (dirR == 2){
			  rightCtrlf *= -1;
		  }
		  HAL_UART_Transmit(&huart5, &rightCtrlf, 4, 1);

		  HAL_TIM_Base_Stop(&htim11);
		  cnt2 = __HAL_TIM_GET_COUNTER(&htim11);
	}
	if (htim->Instance == TIM13){
		  __HAL_TIM_SET_COUNTER(&htim11, 0);
		  HAL_TIM_Base_Start(&htim11);

		  // todo does the casting work?
		  currentPosition = __HAL_TIM_GET_COUNTER(&htim3);

		  // TODO PID that gets position -> target angle
		  targetAngle = CalculateTargetAngle(targetPosition, currentPosition, rSpeed, Kp2, Ki2, Kd2, &integralPosition, &previousSetAngle, positionTd);

		  HAL_TIM_Base_Stop(&htim11);
		  cnt4 = __HAL_TIM_GET_COUNTER(&htim11);
	}
}

void HAL_ADC_ConvCpltCallback(ADC_HandleTypeDef *hadc)
{
  /* Prevent unused argument(s) compilation warning */
  UNUSED(hadc);
  /* NOTE : This function Should not be modified, when the callback is needed,
            the HAL_ADC_ConvCpltCallback could be implemented in the user file
   */
  __HAL_TIM_SET_COUNTER(&htim11, 0);
  HAL_TIM_Base_Start(&htim11);

  gyroValue = HAL_ADC_GetValue(hadc);
  calculateGyroAngle();

  HAL_TIM_Base_Stop(&htim11);
  cnt3 = __HAL_TIM_GET_COUNTER(&htim11);

}


void HAL_GPIO_EXTI_Callback(uint16_t GPIO_Pin)
{
    if (GPIO_Pin == GPIO_PIN_1)   // Check which pin triggered
    {
    	  // get error register motor driver

    	  HAL_UART_Transmit(&huart2, &errorRegisterAddress, 1, 1);
    	  HAL_UART_Receive(&huart2, &errorRegisterData, 1, 1);
    	  while(HAL_GPIO_ReadPin(GPIOC, GPIO_PIN_1) == GPIO_PIN_RESET){
    		  errorRegisterData;
    	  }
    }
}


/* USER CODE END 4 */
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
