GameZebra/BalanceMaster/BMasterControl/SteadyBalancePID/SteadyBalancePID.ioc

Mcu.UserName=STM32F407VGTx
PA0-WKUP.Signal=S_TIM2_CH1_ETR
PA1.Signal=S_TIM2_CH2
PA2.Signal=USART2_TX
PA3.Signal=USART2_RX
PA4.Signal=ADCx_IN4
PA5.Signal=SPI1_SCK
PA6.Signal=SPI1_MISO
PA7.Signal=SPI1_MOSI
PC1.Signal=GPXTI1
PC10.Signal=UART4_TX
PC11.Signal=UART4_RX
PC12.Signal=UART5_TX
PC6.Signal=S_TIM3_CH1
PC7.Signal=S_TIM3_CH2
PD2.Signal=UART5_RX
PE0.Signal=GPXTI0
PE3.Signal=GPIO_Output
PH0-OSC_IN.Signal=RCC_OSC_IN
PH1-OSC_OUT.Signal=RCC_OSC_OUT
