GameZebra/BalanceMaster/record_wheel_speed.ini

[MainWindow]
size=@Size(1680 987)
pos=@Point(1920 -8)
activePanel=Port
hidePanels=false
maximized=true
state=@ByteArray(\0\0\0\xff\0\0\0\0\xfd\0\0\0\0\0\0\x6\x90\0\0\x3\x8e\0\0\0\x4\0\0\0\x4\0\0\0\b\0\0\0\b\xfc\0\0\0\x1\0\0\0\x2\0\0\0\x3\0\0\0\f\0t\0\x62\0P\0l\0o\0t\x1\0\0\0\0\xff\xff\xff\xff\0\0\0\0\0\0\0\0\0\0\0\x1a\0t\0\x62\0P\0o\0r\0t\0\x43\0o\0n\0t\0r\0o\0l\x1\0\0\0i\xff\xff\xff\xff\0\0\0\0\0\0\0\0\0\0\0\x10\0t\0\x62\0R\0\x65\0\x63\0o\0r\0\x64\x1\0\0\x2)\xff\xff\xff\xff\0\0\0\0\0\0\0\0)

[Port]
selectedPort=COM5
baudRate=115200
parity=none
dataBits=8
stopBits=1
flowControl=none

[DataFormat]
format=binary

[DataFormat_Binary]
numOfChannels=6
numberFormat=float
endianness=little

[DataFormat_ASCII]
numOfChannels=auto
hex=false
delimiter=other
customDelimiter=|
filterMode=disabled
filterPrefix=

[DataFormat_CustomFrame]
numOfChannels=6
numberFormat=float
endianness=little
frameStart=AA BB
fixedSize=field1byte
frameSize=1
checksum=false
debugMode=false

[Channels]
channel\1\name=encoderR
channel\1\color=@Variant(\0\0\0\x43\x1\xff\xff\xff\xff\0\0VV\0\0)
channel\1\visible=false
channel\1\gain=1
channel\1\gainEnabled=false
channel\1\offset=0
channel\1\offsetEnabled=false
channel\2\name=encoderL
channel\2\color=@Variant(\0\0\0\x43\x1\xff\xff~~--\xd2\xd2\0\0)
channel\2\visible=false
channel\2\gain=1
channel\2\gainEnabled=false
channel\2\offset=0
channel\2\offsetEnabled=false
channel\3\name=Rspeed
channel\3\color=@Variant(\0\0\0\x43\x1\xff\xff\0\0\xae\xae~~\0\0)
channel\3\visible=true
channel\3\gain=1
channel\3\gainEnabled=false
channel\3\offset=0
channel\3\offsetEnabled=false
channel\4\name=Lspeed
channel\4\color=@Variant(\0\0\0\x43\x1\xff\xff\xfe\xfe\x89\x89\0\0\0\0)
channel\4\visible=true
channel\4\gain=1
channel\4\gainEnabled=false
channel\4\offset=0
channel\4\offsetEnabled=false
channel\5\name=Rcontrol
channel\5\color=@Variant(\0\0\0\x43\x1\xff\xff\xff\xff\x93\x93~~\0\0)
channel\5\visible=true
channel\5\gain=1
channel\5\gainEnabled=false
channel\5\offset=0
channel\5\offsetEnabled=false
channel\6\name=Lcontrol
channel\6\color=@Variant(\0\0\0\x43\x1\xff\xffjj\x82\x82ll\0\0)
channel\6\visible=true
channel\6\gain=1
channel\6\gainEnabled=false
channel\6\offset=0
channel\6\offsetEnabled=false
channel\7\name=Channel 7
channel\7\color=@Variant(\0\0\0\x43\x1\xff\xff\xff\xff\x2\x2\x9d\x9d\0\0)
channel\7\visible=true
channel\7\gain=1
channel\7\gainEnabled=false
channel\7\offset=0
channel\7\offsetEnabled=false
channel\8\name=Channel 8
channel\8\color=@Variant(\0\0\0\x43\x1\xff\xff\0\0\xb9\xb9\x17\x17\0\0)
channel\8\visible=true
channel\8\gain=1
channel\8\gainEnabled=false
channel\8\offset=0
channel\8\offsetEnabled=false
channel\9\name=Channel 9
channel\9\color=@Variant(\0\0\0\x43\x1\xff\xffzzGG\x82\x82\0\0)
channel\9\visible=true
channel\9\gain=1
channel\9\gainEnabled=false
channel\9\offset=0
channel\9\offsetEnabled=false
channel\10\name=Channel 10
channel\10\color=@Variant(\0\0\0\x43\x1\xff\xff\x85\x85\xa9\xa9\0\0\0\0)
channel\10\visible=true
channel\10\gain=1
channel\10\gainEnabled=false
channel\10\offset=0
channel\10\offsetEnabled=false
channel\11\name=Channel 11
channel\11\color=@Variant(\0\0\0\x43\x1\xff\xff\xa4\xa4$$\0\0\0\0)
channel\11\visible=true
channel\11\gain=1
channel\11\gainEnabled=false
channel\11\offset=0
channel\11\offsetEnabled=false
channel\12\name=Channel 12
channel\12\color="@Variant(\0\0\0\x43\x1\xff\xffhh==;;\0\0)"
channel\12\visible=true
channel\12\gain=1
channel\12\gainEnabled=false
channel\12\offset=0
channel\12\offsetEnabled=false
channel\13\name=Channel 13
channel\13\color=@Variant(\0\0\0\x43\x1\xff\xff\xbd\xbd\xc6\xc6\xff\xff\0\0)
channel\13\visible=true
channel\13\gain=1
channel\13\gainEnabled=false
channel\13\offset=0
channel\13\offsetEnabled=false
channel\14\name=Channel 14
channel\14\color=@Variant(\0\0\0\x43\x1\xff\xff&&44\0\0\0\0)
channel\14\visible=true
channel\14\gain=1
channel\14\gainEnabled=false
channel\14\offset=0
channel\14\offsetEnabled=false
channel\15\name=Channel 15
channel\15\color=@Variant(\0\0\0\x43\x1\xff\xff\xbd\xbd\xd3\xd3\x93\x93\0\0)
channel\15\visible=true
channel\15\gain=1
channel\15\gainEnabled=false
channel\15\offset=0
channel\15\offsetEnabled=false
channel\16\name=Channel 16
channel\16\color=@Variant(\0\0\0\x43\x1\xff\xff\xd5\xd5\xff\xff\0\0\0\0)
channel\16\visible=true
channel\16\gain=1
channel\16\gainEnabled=false
channel\16\offset=0
channel\16\offsetEnabled=false
channel\17\name=Channel 17
channel\17\color=@Variant(\0\0\0\x43\x1\xff\xff\x9e\x9e\0\0\x8e\x8e\0\0)
channel\17\visible=true
channel\17\gain=1
channel\17\gainEnabled=false
channel\17\offset=0
channel\17\offsetEnabled=false
channel\18\name=Channel 18
channel\18\color=@Variant(\0\0\0\x43\x1\xff\xff\0\0\x15\x15\x44\x44\0\0)
channel\18\visible=true
channel\18\gain=1
channel\18\gainEnabled=false
channel\18\offset=0
channel\18\offsetEnabled=false
channel\19\name=Channel 19
channel\19\color=@Variant(\0\0\0\x43\x1\xff\xff\xc2\xc2\x8c\x8c\x9f\x9f\0\0)
channel\19\visible=true
channel\19\gain=1
channel\19\gainEnabled=false
channel\19\offset=0
channel\19\offsetEnabled=false
channel\20\name=Channel 20
channel\20\color=@Variant(\0\0\0\x43\x1\xff\xff\xff\xfftt\xa3\xa3\0\0)
channel\20\visible=true
channel\20\gain=1
channel\20\gainEnabled=false
channel\20\offset=0
channel\20\offsetEnabled=false
channel\size=20

[Plot]
numOfSamples=1000
plotWidth=1000
indexAsX=true
xMax=1000
xMin=0
autoScale=true
yMax=1000
yMin=0
lineThickness=1
darkBackground=false
grid=false
minorGrid=false
legend=true
multiPlot=false
symbols=auto
legendPos=topleft
numLines=1000
decimals=6

[Commands]
command\1\name=Command 1
command\1\type=ascii
command\1\data=
command\size=1

[Record]
autoIncrement=true
recordPaused=true
stopOnClose=true
header=true
disableBuffering=false
separator=","
decimals=6
timestamp=false
timestampFormat=seconds

[UpdateCheck]
periodicCheck=false
lastCheck=2025-08-10
