GameZebra/BalanceMaster/BMasterControl/SteadyBalancePID/Core/Src/KalmanFilter.c

/*
 * KalmanFilter.c
 *
 *  Created on: Aug 20, 2025
 *      Author: mrxmi
 */

#include "KalmanFilter.h"

arm_matrix_instance_f32 X;    // state vector [theta; omega; bias]
arm_matrix_instance_f32 P;    // covariance
arm_matrix_instance_f32 Q;    // process noise
arm_matrix_instance_f32 R;    // measurement noise
arm_matrix_instance_f32 K;    // Kalman gain
arm_matrix_instance_f32 H;    // measurement matrix

					// [angle, angularVelocity, bias]
float32_t X_data[STATE_SIZE] = {0, 0, 0};
float32_t P_data[STATE_SIZE*STATE_SIZE] = {	1, 0, 0,	// covariance P initial guess
											0, 1, 0,
											0, 0, 1};
// process noise Q
float32_t Q_data[STATE_SIZE*STATE_SIZE] = {	0.4, 	0, 			0,				// q_theta
											0, 		0.6,	 	0,				// q_omega
											0,		0,			0.000001};		// q_bias
//measurement noise R
float32_t R_data[MEAS_SIZE*MEAS_SIZE] = {	6.5,	0,				//acc noise variance
										 	0,		1.44};			//gyro noise variance

// measurments matrixes
float32_t H_data[MEAS_SIZE*STATE_SIZE] = {	1, 0, 0,	//H_acc
											0, -1, 1};	//H_gyro

// state transition matrix A
const float32_t alph = 0.95;
float32_t A_data[STATE_SIZE*STATE_SIZE] = {	1, gyroTd, 0,
											0, 1, -1,
											0, 1-alph, alph};
// a priori
arm_matrix_instance_f32 A;
arm_matrix_instance_f32 X_pred;
float32_t X_pred_data[STATE_SIZE];
arm_matrix_instance_f32 AP, APAT;
float32_t AP_data[STATE_SIZE*STATE_SIZE], APAT_data[STATE_SIZE*STATE_SIZE];

arm_matrix_instance_f32 AT;
float32_t AT_data[STATE_SIZE*STATE_SIZE];


// K = P*H' * inv(H*P*H' + R)
arm_matrix_instance_f32 HT, HP, HPHT, HPHT_plus_R, HPHT_plus_R_inv;
float32_t HT_data[STATE_SIZE*MEAS_SIZE], HP_data[STATE_SIZE*MEAS_SIZE];
float32_t HPHT_data[MEAS_SIZE*MEAS_SIZE], HPHT_plus_R_data[MEAS_SIZE*MEAS_SIZE];
float32_t HPHT_plus_R_inv_data[MEAS_SIZE*MEAS_SIZE];
float32_t K_data[STATE_SIZE*MEAS_SIZE] = {0,0,0,0,0,0};

// X = X_pred + K*(z - H*X_pred)
float32_t z_data[MEAS_SIZE] = {0, 0};
arm_matrix_instance_f32 z;


arm_matrix_instance_f32 HX, z_minus_HX, Kz;
float32_t HX_data[MEAS_SIZE], z_minus_HX_data[MEAS_SIZE], Kz_data[STATE_SIZE];

arm_matrix_instance_f32 KH, KHP, P_minus_KHP, Eye;
float32_t KH_data[STATE_SIZE*STATE_SIZE], KHP_data[STATE_SIZE*STATE_SIZE], P_minus_KHP_data[STATE_SIZE*STATE_SIZE], Eye_data[STATE_SIZE*STATE_SIZE];


void KalmanInit(){
	arm_mat_init_f32(&X, STATE_SIZE, 1, X_data);
	arm_mat_init_f32(&P, STATE_SIZE, STATE_SIZE, P_data);
	arm_mat_init_f32(&Q, STATE_SIZE, STATE_SIZE, Q_data);
	arm_mat_init_f32(&R, MEAS_SIZE, MEAS_SIZE, R_data);
	arm_mat_init_f32(&H, MEAS_SIZE, STATE_SIZE, H_data);


	// X_pred = A * X
	arm_mat_init_f32(&A, STATE_SIZE, STATE_SIZE, A_data);
	arm_mat_init_f32(&X_pred, STATE_SIZE, 1, X_pred_data);



	// P_pred = A*P*A' + Q
	arm_mat_init_f32(&AP, STATE_SIZE, STATE_SIZE, AP_data);
	arm_mat_init_f32(&APAT, STATE_SIZE, STATE_SIZE, APAT_data);

	arm_mat_init_f32(&AT, STATE_SIZE, STATE_SIZE, AT_data);

	// K = P*H' * inv(H*P*H' + R)
	arm_mat_init_f32(&HP, STATE_SIZE, MEAS_SIZE, HP_data);
	arm_mat_init_f32(&HT, STATE_SIZE, MEAS_SIZE, HT_data);
	arm_mat_init_f32(&HPHT, MEAS_SIZE, MEAS_SIZE, HPHT_data);
	arm_mat_init_f32(&HPHT_plus_R, MEAS_SIZE, MEAS_SIZE, HPHT_plus_R_data);
	arm_mat_init_f32(&HPHT_plus_R_inv, MEAS_SIZE, MEAS_SIZE, HPHT_plus_R_inv_data);
	arm_mat_init_f32(&K, STATE_SIZE, MEAS_SIZE, K_data);

	arm_mat_init_f32(&z, MEAS_SIZE, 1, z_data);
	arm_mat_init_f32(&HX, MEAS_SIZE, 1, HX_data);
	arm_mat_init_f32(&z_minus_HX, MEAS_SIZE, 1, z_minus_HX_data);
	arm_mat_init_f32(&Kz, STATE_SIZE, 1, Kz_data);

	// P = P - K*H*P
	arm_mat_init_f32(&KH, STATE_SIZE, STATE_SIZE, KH_data);
	arm_mat_init_f32(&KHP, STATE_SIZE, STATE_SIZE, KHP_data);
	arm_mat_init_f32(&P_minus_KHP, STATE_SIZE, STATE_SIZE, P_minus_KHP_data);
	arm_mat_init_f32(&Eye, STATE_SIZE, STATE_SIZE, Eye_data);
}


void KalmanPredict(){
	// X_pred = A * X
	arm_mat_mult_f32(&A, &X, &X_pred);

	// P_pred = A*P*A' + Q
	arm_mat_mult_f32(&A, &P, &AP);
	arm_mat_trans_f32(&A, &AT);
	arm_mat_mult_f32(&AP, &AT, &APAT);
	arm_mat_add_f32(&APAT, &Q, &P);  // P = P_pred
}

void KalmanUpdate(){
	// TODO leave here only the calculations
	// move the initializations in the init
	// check the where the measurments enter and leave them here




	// K = P*H' * inv(H*P*H' + R)
	arm_mat_trans_f32(&H, &HT);
	arm_mat_mult_f32(&P, &HT, &HP);
	arm_mat_mult_f32(&H, &HP, &HPHT);
	arm_mat_add_f32(&HPHT, &R, &HPHT_plus_R);
	arm_mat_inverse_f32(&HPHT_plus_R, &HPHT_plus_R_inv);
	arm_mat_mult_f32(&HP, &HPHT_plus_R_inv, &K);


	// X = X_pred + K*(z - H*X_pred)
	z_data[0] = accAngle;
	z_data[1] = angularVelocity;

	arm_mat_mult_f32(&H, &X_pred, &HX);
	arm_mat_sub_f32(&z, &HX, &z_minus_HX);
	arm_mat_mult_f32(&K, &z_minus_HX, &Kz);
	arm_mat_add_f32(&X_pred, &Kz, &X);

	// P = P - K*H*P
	arm_mat_mult_f32(&K, &H, &KH);
	arm_mat_mult_f32(&KH, &P, &KHP);
	arm_mat_sub_f32(&P, &KHP, &P_minus_KHP);
	arm_mat_mult_f32(&Eye, &P_minus_KHP, &P); // P_pred = P

}
