GameZebra/BalanceMaster/(commit log)

2025-01-07 reference documentation for stm, and sensor boards
2025-01-29 matlab com reading terminal print
2025-01-30 motor driver initial commit
2025-01-31 lowering comunication speed because of the voltage devidor
2025-02-01 demo test motor start stop
2025-02-04 reads the encoder and shows the value in live expression
2025-02-13 gyro setup explained
2025-02-17 gyro adc read
2025-02-17 gyro reading (not complete)
2025-02-18 gyro working
2025-02-18 calibration idea + comments
2025-02-21 accelerometer documentation added
2025-02-28 test timer interupts
2025-03-04 working timer interupt
2025-03-05 uart transmision added
2025-03-05 gyro read unified
2025-03-07 adc timer fixed
2025-03-07 accelerometer reading function
2025-05-14 gyro doc for simple use (not here yet)
2025-05-20 accelerometer angle calculation
2025-05-20 working state of frankenBot, reads both sensors
2025-05-20 badly configured PID, but functional
2025-05-22 PID params play
2025-05-22 best_v01 PID
2025-05-22 best_v02 PID
2025-05-23 best_v03 PID almost stable goes to one side
2025-05-23 best_v04 PID stays uprite for a while (too agressive)
2025-05-27 tested get motor current command
2025-05-27 current experimets
2025-05-27 current timers and both working
2025-05-27 encoder read + speed + TODO
2025-05-27 tried accelerometer filtration (didn't work)
    [main.c]
2025-05-28 fixed encoder mode T1 and T2
    [MotorEncodeRead.ioc, main.c]
2025-05-28 encoders added to frankenBot
2025-05-28 tried brake before revere, not working properly
    [main.c]
2025-05-29 fixed problem with the moving average
    [main.c]
2025-05-30 log 28.05
    [configuration_params.txt]
2025-06-04 driver test reversed
2025-06-04 time, angles, encoders
2025-06-05 working motor driver functions
2025-06-05 almost stable (filtration of unrealistic angle values and new pid values)
2025-06-06 accelerometer lib created
2025-06-12 gyro reading library
2025-06-12 calibrated the gyro using the accelerometer
2025-06-25 gyro and accel lib
2025-06-25 encoders lib
2025-06-25 uart transmit lib
2025-06-30 test filters
2025-08-06 speed regulator base
2025-08-06 speed regulator redy
2025-08-06 regulator tuned on the right wheel
2025-08-06 speed regulator for both motors
2025-08-11 working speed regulator passable tune
2025-08-11 motor tests
2025-08-11 experiments data
    [static_graph_1.csv, time_response.csv]
2025-08-12 haracteristics + pid tune something
2025-08-13 fixed ts of the regulator and pid coefficients
    [encoders.c, main.c, speedRegulator.ioc]
2025-08-13 pid tune for descrete system
    [no_load time_response.csv]
2025-08-13 better graphs, and time response recorded
    [no_load time_response_1.csv]
2025-08-14 libraries updated, builds no problem
    [SteadyBalancePID.ioc, accelerometer.c, accelerometer.h, control.c, control.h, encoders.c, encoders.h, main.c]
2025-08-14 speed regulator works with the modified libraries
2025-08-14 middle pid done, works, bad tune
2025-08-15 created file for choosing the best filter for the task
    [acc_data.csv]
2025-08-15 experimets and data processing
    [acc_velocity_normal work_no_motors.csv, acc_velocity_normal_work_motors_on.csv, acc_velocity_stationary.csv, acc_velocity_stationary_1.csv, encoder+speed_syntetic.csv, lSpeed_ctrl.csv, lSpeed_speed.csv, lSpeed_speed_1.csv]
2025-08-15 new tests with the filter
2025-08-15 new filtration added (makes the control unstable)
    [encoders.c, encoders.h, filters.c, filters.h, main.c]
2025-08-15 new test files
    [time_response_iir_filter_4.csv]
2025-08-16 new experiments + filters with less phase shift
    [bare_encoder_stat.csv, bare_encoder_stat_1.csv]
2025-08-16 experiment for the encoder filter
2025-08-16 implemented fir + moving average for encoders
2025-08-18 kalman test
    [acc_velocity_normal_work_no_motors.csv]
2025-08-28 kalman tests and visualizations
    [data+kalman_vibrations.csv, kalman_the_great.csv]
2025-08-28 4th order kalman filter
2025-08-28 motor time response coeficients tune to be the same
2025-09-01 revert 4th order + trying to add LF to Kalman (didn't work)
    [KalmanFilter.c, KalmanFilter.h, control.c]
